the-tee-box/SimSlider/GSPro_Actuator_Wiring_Guide.docx

GSPro Linear Actuator Wiring Guide

(Actuator with Built-In Limit Switches)

# Complete Parts List

### Electronics

- Arduino Uno R3
- BTS7960 43A Motor Driver Module
- 16V 10A Power Supply (for actuator via BTS7960)
- 12V Power Supply with barrel connector (for Arduino)
- USB Isolator Module
- USB A-to-B cable (6ft)
- 3x 1000µF 25V Electrolytic Capacitors

### Safety Components (Optional)

- 1x Emergency Stop Button (mushroom, NC, red) - Optional
- 3x LEDs (Red, Green, Yellow) - Optional but recommended
- 3x 220Ω resistors (for LEDs)

### Mounting & Wiring

- Project enclosure (6"x4"x3" minimum)
- Terminal blocks (screw type)
- 14AWG stranded wire (for long actuator run - red/black)
- 18AWG wire (for local power connections)
- 22AWG wire (for signals)
- Wire ferrules and heat shrink
- Cable glands for enclosure
- Rubber grommets or washers (for vibration dampening)

# Power Distribution

16V 10A Power Supply (Actuator Power)

└─→ 3x 1000µF Capacitors (parallel at B+/B-)

└─→ BTS7960 B+ and B-

└─→ 14AWG twisted pair (35ft) → Linear Actuator

12V Power Supply (Arduino Power)

└─→ Arduino barrel jack connector

PC USB Port

└─→ USB Isolator Module

└─→ Arduino USB port (data only)

Star Ground Connection:

├─→ 16V Power Supply GND

├─→ 12V Power Supply GND

├─→ BTS7960 B-

└─→ Arduino GND

Important Notes:

- Two separate power supplies: 16V for actuator, 12V for Arduino
- All grounds connected at a single star ground point
- USB Isolator between PC and Arduino for noise isolation
- Use 14AWG stranded twisted pair for long actuator wire run
- 3x 1000µF capacitors at BTS7960 B+/B- for EMI suppression
- Add inline fuse (10A) on 16V line for safety

# Arduino Pin Connections

### Motor Driver (BTS7960)

BTS7960 Pin | Arduino Pin | Description
RPWM | 5 | Right PWM (retract = RH)
LPWM | 6 | Left PWM (extend = LH)
R_EN | 7 | Right Enable
L_EN | 8 | Left Enable
VCC | 5V | Logic power
GND | GND | Common ground (star ground)

### BTS7960 Power Connections

BTS7960 Pin | Connection
B+ | 16V Power Supply + (through 3x 1000µF caps)
B- | 16V Power Supply - (star ground)
M+ | 14AWG to Actuator wire 1 (red)
M- | 14AWG to Actuator wire 2 (black)

### Safety Switch (Optional)

Component | Arduino Pin | Notes
E-Stop Button (NC) | Pin 4 | Use INPUT_PULLUP, optional

### Status LEDs (Optional - with 220Ω resistors)

LED Color | Arduino Pin | Meaning
Red | Pin 10 | Left-Handed Position
Green | Pin 11 | Right-Handed Position
Yellow | Pin 12 | Moving

LED Wiring: Arduino Pin → 220Ω Resistor → LED Anode (+) → LED Cathode (-) → GND

# Long Actuator Wire Run

This configuration places the Arduino, BTS7960, and power supplies near the PC, with a long wire run to the remotely-mounted actuator. This keeps EMI-generating components away from sensitive USB communication.

### Wire Specifications

Parameter | Specification
Wire Gauge | 14 AWG stranded copper
Wire Length | 35 feet (each conductor)
Configuration | Twisted pair (1-2 twists per inch)
Voltage Drop | ~1.1V at 5A (actuator sees ~14.9V)
Current Rating | 5A maximum (actuator spec)

### Best Practices for Long Wire Run

- Twist the positive and negative wires together for the entire run
- Keep both conductors bundled - do not run on separate paths
- Add a 100-1000µF capacitor at the actuator end for local energy storage
- Optional: ferrite clamp at actuator end to suppress motor brush noise
- Use quality terminal connections or solder joints at both ends

# USB Isolator Installation

The USB isolator provides galvanic isolation between the PC and Arduino, preventing electrical noise from the motor circuit from disrupting USB communication.

PC USB Port

│

└─→ [USB Isolator Module] ←── Install at Arduino end

│

└─→ Arduino USB Port

Installation Notes:

- Install isolator at the Arduino end of the USB cable
- Keep USB cable as short as practical (6ft recommended)
- USB provides data only - Arduino powered separately via 12V barrel jack

# Actuator Built-In Limit Switches

Your actuator has internal limit switches that automatically:

- Stop extension at full stroke (28"/30")
- Stop retraction at 0"
- Prevent damage from over-travel
- Cut power when limits are reached

No external switches needed! The Arduino uses timed movement:

- Calculates expected movement time (~21 seconds for 28")
- Stops sending power after movement completes
- Built-in limits provide hardware backup

# Emergency Stop Wiring (Optional)

Arduino Pin 4 ──── [E-Stop Button (NC)] ──── GND

When E-stop pressed: button opens, pin floats HIGH (via pullup) → motor stops

Normal operation: button closed, pin LOW

Note: E-stop is optional since actuator has built-in protection. However, it is good practice for any automated system.

# Assembly Steps

### 1. Prepare Enclosure

Drill holes for:

- USB cable gland
- 12V Arduino power input
- 16V BTS power input
- Actuator output (2-wire connection for 14AWG)
- E-stop button mounting (optional)
- Status LEDs (front panel, optional)

### 2. Mount Components Inside Enclosure

- Arduino on standoffs
- BTS7960 driver on standoffs (ensure good airflow)
- 3x 1000µF capacitors near BTS7960 B+/B- terminals
- Terminal blocks for connections

### 3. Power Wiring (POWER OFF!)

16V Supply + ──[FUSE 10A]──┬─→ 1000µF caps (+) ─→ BTS7960 B+

│

16V Supply - ──────────────┼─→ 1000µF caps (-) ─→ BTS7960 B-

│

└─→ Star Ground ←─┬─ 12V Supply -

└─ Arduino GND

12V Supply + ─────────────────→ Arduino barrel jack center (+)

12V Supply - ─────────────────→ Star Ground

### 4. Signal Wiring

- Connect Arduino to BTS7960 per pin table above
- Connect E-stop to pin 4 (if using)
- Connect LEDs to pins 10, 11, 12 (if using)

### 5. Actuator Connection

- BTS7960 M+ → 14AWG twisted pair → Actuator red wire
- BTS7960 M- → 14AWG twisted pair → Actuator black wire
- Optional: Add 100-1000µF cap across actuator terminals at actuator end

### 6. USB Connection

- PC USB port → USB Isolator → Arduino USB port

# Vibration Dampening (Actuator Mount)

To reduce acoustic noise transmitted through the mounting structure:

- Use rubber grommets or washers at each mounting screw
- Place rubber washers on both sides of the mounting plate
- Optional: thin rubber pad between mounting plate and beam
- Rubber grommets are more durable than foam for long-term use

# Testing Procedure

### Phase 1: Power-On Test (No Actuator)

1. Connect 16V power to BTS7960
2. Connect 12V power to Arduino barrel jack
3. Arduino power LED should light
4. Connect USB through isolator to PC
5. Upload Arduino code
6. Open Serial Monitor (9600 baud)
7. Should see "GSPro Actuator Controller Ready"

### Phase 2: Manual Control Test (No Actuator)

1. Type "STATUS" in Serial Monitor → verify response
2. Status LEDs should indicate current state (if installed)
3. Press E-stop (if installed) → LEDs should flash
4. Release E-stop → normal operation

### Phase 3: Actuator Test (REDUCED SPEED)

⚠️ Reduce MOVE_SPEED in code to 128 (50% speed) for initial testing

1. Connect actuator via 14AWG twisted pair
2. Ensure clear travel path - nothing in the way!
3. Actuator should start in retracted position (RH)
4. Send "LH" command → actuator extends slowly
5. Watch it extend - built-in limit will stop it
6. Send "RH" command → actuator retracts slowly
7. Verify E-stop immediately stops motion (if installed)
8. Verify USB connection remains stable during movement

### Phase 4: Full Speed Test

1. Restore MOVE_SPEED to 255 in code
2. Upload updated code
3. Send "RH" to ensure starting position
4. Send "LH" command and time the movement
5. Send "RH" command and time the return
6. Adjust MOVE_TIME constants if timing is off

### Phase 5: Python Integration Test

1. Ensure: pip install pyserial
2. Run Python script
3. Should auto-detect Arduino
4. Change player handedness in GSPro
5. Verify actuator moves automatically
6. Test multiple switches back and forth

# Calibration & Fine-Tuning

### Speed Adjustment

- Modify MOVE_SPEED (0-255) in Arduino code
- Lower values = slower, quieter
- Higher values = faster movement
- Recommend 200-255 for normal use
- Note: 16V supply provides ~33% more speed than 12V

### Timing Calibration

After testing, measure actual movement times:

- Time LH to RH movement
- Time RH to LH movement
- Update MOVE_TIME_LH_TO_RH and MOVE_TIME_RH_TO_LH in code
- Set MOVE_BUFFER (safety buffer, 2-3 seconds)

### Direction Correction

If actuator moves wrong direction:

- Option 1: Swap M+ and M- wires at BTS7960
- Option 2: In Arduino code, swap moveLeft() and moveRight() functions

# Troubleshooting

### Actuator doesn't move

- Check 16V power supply with multimeter
- Verify BTS7960 connections
- Test M+ and M- voltage when moving (should show ~16V)
- Check Arduino pins 7 & 8 (enable pins) are going HIGH
- Verify RPWM/LPWM pins are outputting PWM
- Check 14AWG connections at both ends

### USB disconnects during movement

- Verify USB isolator is installed at Arduino end
- Check star ground connections are secure
- Verify 1000µF capacitors are properly connected at BTS7960
- Ensure actuator wires are twisted pair
- Add ferrite clamp to actuator wires at actuator end

### Moves wrong direction

- Swap M+ and M- wires on BTS7960
- Or swap RPWM/LPWM functionality in code

### Movement time is wrong

- Measure actual time with stopwatch
- Update MOVE_TIME constants in code
- Note: 16V will be faster than original 12V timing
- Account for load - movement may be slightly slower with weight

### Python can't find Arduino

- Check USB cable is data-capable (not charge-only)
- Verify USB isolator is working (LEDs if present)
- Check Device Manager (Windows) for COM port
- Install Arduino drivers if needed
- Manually specify port in Python code if auto-detect fails

### Erratic movement or buzzing

- Reduce MOVE_SPEED
- Verify 1000µF capacitors are connected correctly
- Check all ground connections are secure at star ground
- Ensure 16V power supply can deliver 10A

# Safety Notes

⚠️ IMPORTANT SAFETY WARNINGS:

1. Clear travel path before automated operation
2. Built-in limits are primary protection
3. Keep hands clear during automated movement
4. Test at reduced speed first
5. Use proper wire gauge for current capacity (14AWG for long run)
6. Secure all connections with ferrules or solder
7. Mount enclosure securely
8. Label all wiring clearly
9. E-stop provides additional safety layer
10. Disconnect BOTH power supplies when working on system
11. 16V exceeds actuator rating - monitor for overheating

# System Advantages

✓ Stable USB connection - electronics near PC, long wire to actuator

✓ EMI isolation - USB isolator + capacitors + twisted pair

✓ Faster actuator speed - 16V supply vs 12V rated

✓ Simpler wiring - No external limit switch installation

✓ More reliable - Factory-calibrated limit positions

✓ Independent power - Separate supplies for logic and motor

✓ Vibration dampened - Rubber grommets at actuator mount

# Recommended Improvements

### Optional Enhancements

- Current Sensing - Detect obstructions or jams
- HC-05 Bluetooth Module - Wireless control alternative
- OLED Display - Show status without PC
- Buzzer - Audio feedback for movements
- Manual Control Pendant - Wired remote with RH/LH buttons
- Soft Start/Stop - Acceleration ramps for smoother motion

### Future Upgrades

- Mobile app control via Bluetooth
- Integration with other sim equipment
- Voice control
- Data logging (movements, errors, usage hours)
- Temperature monitoring for overvolted actuator
